paytongoodrich/hexagon-LED-arches/BBBB7803-27BB-41D0-A505-E8BAEE371DE0_1_105_c.jpeg

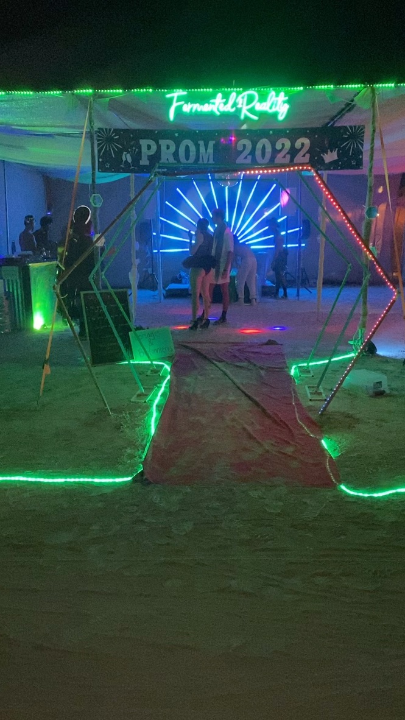
BBBB7803-27BB-41D0-A505-E8BAEE371DE0_1_105_c.jpeg
